HoDZadkiel/EnviroSense/docs/overview.md

# 設計總覽

> 本文件是專案 README 原本的長篇設計說明，為了讓 README 回到「簡介與快速開始」而移到這裡，內容未改（僅調整連結）。
> 專案簡介、快速開始與硬體規格見 [README](../README.md)。
> 2026-10-28 已依現行設計更新：電池以 **21700（5000 mAh）** 為準、設定頁改連按兩次 RESET、里程碑與未完成項目對照現場運行狀況。
> 韌體原始碼不公開，文中提到原始碼的地方只是設計說明。

## 核心結論：成敗在 WiFi 連線優化

決定「醒來就傳」之後，**上傳佔了電路總耗電的 76.2%**（5 分鐘模式），
深睡電流只佔 4.3%。喚醒視窗的長度幾乎就是唯一的設計變數。

未優化的 Arduino 寫法（`WiFi.begin(ssid, pass)` + DHCP + DNS）約需 **4 秒**，
把時間花在這些地方：

| 階段 | 未優化 | 優化後 | 手段 |
|---|---|---|---|
| 開機 / 載入 app | 250 ms | 150 ms | 跳過映像驗證、QIO 80MHz |
| WiFi init + start | 300 ms | 210 ms | PHY 部分校正 |
| **全頻掃描找 AP** | 800 ms | **0 ms** | 快取 BSSID + channel |
| **關聯 + WPA2 握手**  | 1100 ms | 350 ms | 已知 BSSID/channel、訊號好 |
| **DHCP 取得 IP** | 1000 ms | **0 ms** | 靜態 IP |
| DNS 查 broker | 200 ms | **0 ms** | 直接寫 IP |
| MQTT 連線+送出+斷線 | 300 ms | 250 ms | 不開 TLS、payload 小 |
| 收尾進睡 | 50 ms | 40 ms | |
| **合計** | **4000 ms** | **1000 ms** | **能量降為 22%** |

**這個優化把 5 分鐘模式從不可行變成可行**：

| 間隔 | 未優化 (4.0 s) | 優化後 (1.0 s) | 6 個月所需視窗  |
|---|---|---|---|
| 5 分鐘  | 4.4 個月 ❌ | **14.7 個月** ✅ | ≤ 3.14 s  |
| 15 分鐘 | 11.0 個月 ✅ | **26.8 個月** ✅ | ≤ 9.41 s  |
| 30 分鐘 | 17.7 個月 ✅ | **33.8 個月** ✅ | ≤ 18.82 s |

（21700 5000mAh，含電池自放電與載板 DW01A 保護 IC 靜態電流；數字來自功耗模型，見 [功耗預算](./power-budget.md)。
早期設計用 18650 3000mAh，5 分鐘優化後只有 9.9 個月。）

手段逐項說明、實測數據與來源見 [`docs/wifi-optimization.md`](./wifi-optimization.md)。

## 選 5 / 15 / 30 分鐘哪一個（另有 1 分鐘，僅供續航測試）

| | 5 分鐘 | 15 分鐘 | 30 分鐘 |
|---|---|---|---|
| 續航（21700，優化後） | 14.7 個月 | 26.8 個月 | 33.8 個月 |
| 續航（18650，早期設計） | 9.9 個月 | 20.1 個月 | 27.1 個月 |
| WiFi 優化 | **必要條件** | 加分項 | 加分項 |
| 視窗餘裕（以 1.0 s 計）  | 1.0 / 3.14 s，3.1 倍 | 9.4 s，9.4 倍 | 18.8 s，19 倍  |
| 對 AP 慢的容忍度 | 低 | 高 | 很高 |

**實測結果：視窗遠比預期短。** 已上線節點的 `up` 中位數 523 ms，加上 MQTT 收尾約 0.8 秒，
遠低於 5 分鐘模式的 3.14 秒上限，所以 5 分鐘已證實可行（估算約 16.7 個月，見 [功耗預算](./power-budget.md)）。
韌體把間隔做成可調（設定頁或 MQTT 指令），1 分鐘僅供續航測試。

超過 24 個月的數字沒有實務意義 —— 那時電池自放電與日曆老化的不確定性遠大於負載本身，
所以 30 分鐘的「33.8 個月」實際上應理解為「規劃一年充一次電，餘裕很大」。

## 為什麼是 C6

C3 的板載 LDO（XC6210）靜態電流就有 35 µA，佔其深睡總電流的 78%；
S3/C6 改用 **SGM6029 同步 buck**（2.8 µA，不是 LDO）。從 BAT 焊盤實測的深睡電流差了 3 倍：

| | C3 | S3 | C6（選用） |
|---|---|---|---|
| 深睡實測（BAT 焊盤 3.8V） | 45.1 µA | 11.9 µA | 14.3 µA |
| PSRAM | 無 | 8 MB（喚醒時的負擔） | 無 |
| 充電電流 | 380 mA  | 50 mA | 120 mA |
| 5 分鐘續航（優化後） | 9.1 個月  | 9.2 個月 | **9.9 個月**  |
| 30 分鐘續航（優化後） | 21.6 個月 | 26.6 個月 | **27.1 個月** |

兩個要點：

- **間隔越短，選型越不重要**。5 分鐘時 C6 只領先 C3 9%，因為深睡只佔 4.3%。 這也再次說明：**5 分鐘模式的勝負在 WiFi 優化，不在換板子**
- **S3 深睡最低卻不推薦**：8MB PSRAM 初始化 + 雙核 Xtensa 讓每次喚醒更慢更耗電， 在 5 分鐘時只贏 C3 0.2 個月。且充電只有 50 mA

充電電流看似 C3 大勝，但 9~28 個月才充一次電，C6 用 120 mA 充 21700（5000 mAh）約 42 小時（定電流段，實際略長），完全可接受。
（C6 的充電 IC 是 **SGM40567-4.2**，官方文件寫 100 mA，但原理圖上 R_IREF = 200kΩ
反推是 120 mA。詳見 [`docs/mcu-selection.md`](./mcu-selection.md)。）
完整比較與來源見 [`docs/mcu-selection.md`](./mcu-selection.md)。

## 專案結構

```
EnviroSense/
├── README.md / CLAUDE.md / CHANGELOG.md
├── docs/                設計文件（本檔、power-budget、hardware、mqtt-protocol…）
│   └── data/            遙測資料快照（CSV）
├── hardware/            EasyEDA 專案、Gerber、BOM
├── firmware/release/    預編譯韌體、esptool、flash 腳本（原始碼不公開）
├── web-flasher/         網頁燒錄頁模板
├── deploy/              Mosquitto 與 Home Assistant 設定範例
├── scripts/             power_budget.py 功耗試算（所有月數的唯一來源）
└── .github/workflows/   Pages 部署、原始碼外洩防護
```

## 硬體摘要

| 項目 | 選型 | 重點 |
|---|---|---|
| MCU  | Seeed XIAO ESP32C6 | 深睡 14.3 µA、板載充電 **120 mA**（SGM40567-4.2）、u.FL 外接天線 |
| 感測器  | Nyfea SHT40-N-NF | 待機 0.1 µA、量測 6.9 ms、±1.8%RH ±0.2°C、指令相容 SHT4x |
| 電池 | **21700**（載板電池座 BH-21700-B1BJ001） | 截止電壓 **3.3V**，不是 3.0V |
| 電壓量測 | 2MΩ/2MΩ 分壓 **+ 2N7002 閘控** | 官方建議的 200k 分壓會漏 10.5 µA |

**截止電壓 3.3V 的原因**：WiFi 發射瞬間電流達 250~350 mA，電池內阻加 LDO 壓降會讓電壓塌陷。
靜態電壓低於 ~3.4V 時發射瞬間就可能 brownout 重啟 ——
症狀是節點在低電量時隨機重開機、資料出現缺口。放棄最後 3~5% 電量換穩定性划算。

**分壓一定要閘控**：官方建議的 200k 分壓常時漏 10.5 µA，
會讓深睡電流從 14.3 µA 變 24.8 µA。用 2M/2M + 2N7002 閘控可降到接近 0。

電路、接線、BOM 見 [`docs/hardware.md`](./hardware.md)。

## 設定與佈建（WiFiManager）

使用者透過手機連上節點開的 AP 設定，不需重編譯。可設定的項目：
WiFi 憑證、**上傳間隔（1 / 5 / 15 / 30 分鐘下拉選單，1 分鐘僅供測試）**、MQTT broker、以及 IP 策略。

低功耗專案用 WiFiManager 有兩個會咬人的地方，都已在設計中處理：

### 設定入口網站絕不能自動開啟

WiFiManager 預設「連不上就開 portal 等人來設定」。portal 開著約 80 mA，
開 3 分鐘 = **4.0 mAh = 15 分鐘模式一整天的電**。
若因為路由器重開機而每次喚醒都誤開，**電池 6 天見底**。

所以：**連線失敗絕不開 portal**，只把資料存進 pending、指數退避、回去睡。
設定模式只能由人明確觸發（冷開機後 10 秒內連按兩次 RESET；原版曾用 BOOT 鍵，見 [設定與佈建](./provisioning.md)），且有硬性逾時與低電量拒絕。

10 秒的按鍵等待用開機原因迴避 ——
深睡計時器喚醒就是例行上傳，完全跳過等待，零延遲。

### 「記住 DHCP 給的 IP」的假設要修正

靜態 IP 這單獨一項值 **+37% ~ +80%** 續航，**5 分鐘模式靠它才達標**（5.5 → 9.9 個月），
所以很值得做。但「DHCP 會自動避免發同一個 IP 給不同設備」這個前提不成立：

- 節點改用靜態後就不再續約 → 租約必定過期 → IP 回到可分配池
- 家用路由器有黏性，**短期內通常真的沒事**，所以問題會在數週後才浮現
- **關鍵**：路由器發 IP 前的衝突偵測（ping / ARP 探測）對本專案無效 —— 節點 99.9% 在深睡不會回應，路由器判定沒人用就發給別人。 **一般保護靜態 IP 的安全網，剛好對深睡裝置失效**

對策是保留這個做法，但加上續約與退路：

| 模式 | 做法 |
|---|---|
| **自動**（預設，新手不必碰路由器） | 首次 DHCP → 記住 IP → 之後靜態；**每天一次改走 DHCP 續約**；失敗自動退回 DHCP 重新記錄 |
| 手動 | 使用者填路由器保留的 IP，**最安全** |
| 關閉 | 每次都 DHCP，每次多約 1 秒 |

每日續約的成本 **< 1% 續航**，換掉一個數週後才爆發的隱性故障。
設定頁用「☑ 記住 IP 位址以加快連線（推薦）」呈現，避免出現 DHCP、子網路遮罩這種字眼。

完整設計見 [`docs/provisioning.md`](./provisioning.md)。

## 韌體架構

每次喚醒都是一次完整的 `setup()`，沒有 `loop()`。狀態存在 **RTC memory**
（深睡保留、免寫 flash、無磨損）：

```
喚醒
 ├─ 開機原因 != 深睡喚醒？ → 檢查電壓 → LED 亮 10 秒，期間再按一次 RESET → 設定模式
 │                          （例行喚醒完全跳過，零延遲；NVS 沒設定才自動進設定模式）
 ├─ 讀 RTC memory（seq / WiFi cache / 待補送資料 / 失敗次數）+ CRC 校驗
 ├─ 讀 NVS（間隔 / broker / IP 策略 / 快取的 IP）
 ├─ 今天該續約嗎？（每 1440/間隔 次）→ 是則走 DHCP，否則：
 ├─ WiFi.config(快取的 IP)                     ← 跳過 DHCP，省 ~1000ms
 ├─ WiFi.begin(ssid, pass, ch, bssid)          ← 跳過掃描，省 ~800ms
 ├─ ── 趁 WiFi 在背景關聯，同時做以下事 ──      ← 並行，省 ~20ms
 │    ├─ 讀 SHT40（高精度 8.2ms）
 │    └─ 拉高 2N7002 閘極（分壓 τ = 100 ms，要等 ≥ 500 ms 才能讀，見 docs/hardware.md）
 ├─ 等待 WiFi 連上（逾時 5s → 清 cache，全頻掃描挑訊號最強的 AP 重試一次，逾時 30s）
 ├─ 讀電池電壓（dummy read → 讀 → 拉低閘極）   ← 此時閘極已開 ≥ 500 ms
 ├─ esp_wifi_set_ps(WIFI_PS_NONE)              ← 視窗只有 1 秒，求快不求省
 ├─ MQTT connect(clean session, IP 直連) → publish QoS1 → disconnect
 │   ├─ 成功：更新 WiFi cache、清待補送、failCount = 0
 │   └─ 失敗：存進 pending、failCount++、指數退避、
 │             下次改走 DHCP 重新記錄 IP（flags: ip_recache）
 │             ⚠ 絕不開設定入口網站
 └─ esp_deep_sleep(下次間隔)
```

**RTC memory 而非 NVS**：WiFi cache 每次都可能更新，寫 NVS 既耗電又磨損 flash。
NVS 只放 WiFi 憑證這類幾乎不變的設定。RTC memory 內容在異常重開後可能是垃圾，**必須做 CRC 校驗**。

**時間戳不需要處理**：醒來即傳，所以 broker 收到的時間就是量測時間（誤差 < 1 秒）。
不需要 NTP，RTC 振盪器 ±3~5% 的漂移只影響取樣間隔，不影響資料時間正確性。

## MQTT 摘要

```
envirosense/<node_id>/state    ← 感測資料（JSON，QoS1，不 retain）
envirosense/<node_id>/status   ← LWT：online / offline（retain）
envirosense/<node_id>/cmd      ← 下行指令（約一天才訂閱一次）
homeassistant/sensor/...       ← HA 自動探索（retain，僅首次開機發送）
```

```json
{"id":"a1b2c3","seq":1234,"t":24.31,"h":58.2,"vbat":3.92,"rssi":-58,"up":980,"flags":[]}
```

`up` = 本次喚醒視窗耗時（ms），`rssi` = 訊號強度。
**把這兩個欄位存進資料庫，就能在電池真的沒電之前先看出 WiFi 變慢。**
成本 8 bytes，價值是提早幾個月預警。

因為不做批次緩衝，**Home Assistant 完全相容**，不需要額外的資料庫橋接。
完整規格見 [`docs/mqtt-protocol.md`](./mqtt-protocol.md)。

## 開發里程碑

**本專案直接做 PCB，不經洞洞板驗證** —— M5 先行，其餘驗證都在打樣回來的實體板上進行。
里程碑編號沿用原定義，狀態對照 2026-10-28 的現場運行資料（4 個節點、1 分鐘與 5 分鐘間隔）：

- [x] **M5 硬體載板** — EasyEDA Pro 畫板、打樣、焊接完成，見 [`hardware/`](../hardware/)
- [ ] **M0 可行性實測** — 在實體板上實測 C6 深睡電流（驗收：接近 14.3 µA）。
      **延後**：沒有 PPK2，時程未定；改以 M6 實際運行數據估算
      （代價：焊接瑕疵造成的深睡漏電要到 M6 才看得出來，且看不出原因）
- [x] **M1 最小韌體** — 深睡 → 讀 SHT40 → 開 WiFi → MQTT 上傳 → 睡，已在實板運作
- [ ] **M2 WiFi 優化** — 靜態 IP、BSSID 快取、每日 DHCP 續約已實作並在現場運作（`up` 中位 523 ms），
      但**逐項 A/B 對照實測還沒做**，也還沒用 PPK2 回填各階段電流到 `scripts/power_budget.py`
- [x] **M3 韌體強健化** — RTC memory + CRC、失敗補送（`pending`）、指數退避；現場已看到補送與 `seq` 追漏
- [x] **M4 電池管理** — 閘控分壓量測、四段式低電量處理；現場已看到 `low_batt` 旗標與間隔拉長
- [ ] **M6 長期驗證** — 一顆節點連續跑 30 天，用實際放電曲線外推續航（進行中，已累積約 11 天）

WiFiManager 設定頁（連按兩次 RESET 觸發）、HA 自動探索、`cmd` 下行指令也已在實機運作。

## 未完成項目 / 待決事項

- **平均電流仍是估計值**（最高風險）：喚醒視窗長度已在現場量到（`up` 中位 523 ms，加 MQTT 收尾約 0.8 s，比原本假設的 1.0 s 短），但視窗內的**平均電流（75.8 mA）仍是模型值**，還沒用 PPK2 量過。見 [功耗預算](./power-budget.md)
- **BSSID + channel 快取的效果有互相矛盾的證據**：社群宣稱可省 800 ms， 但 Espressif 官方 FAQ 說 ESP32 無法靠 BSSID 加速，且有實測回報用了仍花 3201 ms。 **A/B 對照還沒做**，無效就別留著。新韌體的兩個節點約 6 天內 `cache_miss` 只出現 1 次，但沒有關閉快取的對照組，無法下結論
- **Arduino framework 改不了 sdkconfig**：跳過映像驗證、PHY 校正、RTC 校正三項 是 ESP-IDF 選項，Arduino core 是預編譯二進位檔。這三項合計只省約 250 ms， 建議先走純 Arduino（可拿到 4000 → 1250 ms），不夠再考慮換 ESP-IDF
- **深睡電流未自行實測**：14.3 µA 來自第三方論壇量測
- **間隔未定案**：實測視窗已證實 5 分鐘可行，最終間隔依使用情境決定（續航與資料密度的取捨）
- **C6 的 RF switch 未確認**：C6 疑似有板載天線 + u.FL 兩路由 GPIO 切換， 該腳在深睡時的狀態可能影響耗電
- **C6 的 WiFi6 相容性只有單一環境的觀察**：在現場 mesh AP 上 `up` 中位 523 ms，沒看到變慢；沒有針對 WiFi 4 / 5 / 6 做對照，AP 型號也未記錄
- **佈署環境未定**：室內或戶外？戶外必須用百葉箱，否則日照直射會讓溫度偏高 5~10°C
- **WiFiManager 的體積代價未量測**：會拉進 WebServer + DNSServer，binary 變大。 若沒開 skip-validate，bootloader 每次醒來對整個映像算 SHA256 的時間與大小成正比 —— **M2 必須量加入前後的喚醒視窗差多少**
- **授權條款未定**：尚未建立 LICENSE

### 若 1.0 秒還不夠：ESP-NOW

唯一能再降一個數量級的方法是**不建立 WiFi 連線**。ESP-NOW 不掃描、不關聯、不握手、不要 IP，
喚醒視窗可壓到 **450 ms**，5 分鐘模式續航 **20.4 個月**（是優化後 WiFi 的 2 倍）。

代價是需要一台常供電的 gateway 把 ESP-NOW 轉發成 MQTT，多一個裝置與故障點。
**建議先做完 M2 拿到真實數據再決定** —— 若選 15 或 30 分鐘，WiFi 版已有 20~27 個月，
不需要 gateway 的複雜度。詳見 [`docs/wifi-optimization.md`](./wifi-optimization.md)。

## 注意事項

- **不要引用晶片 datasheet 的深睡電流**。C3 與 C6 同代製程，深睡卻差 3 倍， 差別全在板子的 LDO 選型。要看「從 BAT 焊盤實測」的數字
- **量功耗一定要用 release build 且不插 USB**。插著 USB 時板載充電 IC 會同時供電與充電， 量到的數字毫無意義；USB CDC 開著也會拉長開機時間
- **WiFi 訊號品質直接換算成續航**。優化後 WPA2 握手佔視窗能量 46.2%， 而握手時間取決於 AP 回應速度與訊號品質，節點端無能為力。 佈署點 RSSI 應優於 **-70 dBm**，使用外接天線，**AP 不要開自動換頻道**（會讓快取失效）
- **不要為了省電降頻**。能量 = 功率 × 時間，160 MHz 跑完 1 秒比 80 MHz 跑完 1.8 秒省
- **靜態 IP 必須在路由器排除於 DHCP 池外**，否則遲早撞 IP，症狀是偶發性連不上
- **鋰電池低溫容量衰減**：0°C 約剩 80%，-10°C 約剩 60%。戶外冬季要把上表月數再打折
- 裸電芯務必外加保護板（DW01+8205A），但其過放點在 2.4~2.9V，遠低於本設計的 3.3V —— **保護板保護電芯不燒毀，續航與資料完整性靠韌體**
- 專案已公開在 GitHub：<https://github.com/HoDZadkiel/EnviroSense>，內容只有文件、硬體設計與預編譯韌體，**韌體原始碼不公開**

---

異動紀錄見 [`CHANGELOG.md`](../CHANGELOG.md)。
