HoDZadkiel/EnviroSense/docs/hardware.md

# 硬體設計

## 選型總表

| 項目 | 選型 | 理由 |
|---|---|---|
| MCU | **Seeed XIAO ESP32C6** | 深睡實測 14.3µA、無 PSRAM 負擔、板載充電 120mA（SGM40567-4.2）。詳見 [`mcu-selection.md`](./mcu-selection.md)；EasyEDA 匯入見下方「EDA 素材」 |
| 溫濕度感測器 | **Nyfea SHT40-N-NF**（LCSC `C54946589`） | 待機 0.1µA、±1.8%RH ±0.2°C、I²C 0x44、指令與 Sensirion SHT4x 相容。見下方「感測器選型」 |
| 電池 | **18650**；5 分鐘間隔可考慮 **21700** | 見 [`power-budget.md`](./power-budget.md) |
| 電池座 | Keystone 1043（18650）/ 對應 21700 座 | 需可換電芯，不焊死 |
| 電壓量測 | 2MΩ + 2MΩ 分壓，2N7002 閘控 | 見下方 |
| 天線 | u.FL 外接 2.4GHz | RSSI 改善直接換算成續航 |

## 為什麼分壓要閘控

XIAO 系列**沒有任何一款有專用的電池電壓量測腳**（C3/S3/C6 皆同），
官方文件都建議自己接分壓到 A0。但分壓電阻是常時導通的：

| 分壓阻值 | 常時漏電 | 佔 C6 深睡 14.3µA 的比例 |
|---|---|---|
| 100k + 100k | 21 µA | **147%**（比整個板子還耗電） |
| 200k + 200k（官方建議） | 10.5 µA | **73%** |
| 1M + 1M | 2.1 µA  | 15% |
| 2M + 2M | 1.05 µA | 7.3% |
| 2M + 2M **+ 2N7002 閘控** | ~0 µA | ~0% |

官方建議的 200k 分壓會讓深睡電流從 14.3µA 變成 24.8µA。
影響程度隨間隔而異：5 分鐘模式深睡只佔總耗電 4.3%，掉約 3%；
30 分鐘模式深睡佔 11.8%，掉約 8%。**間隔越長，這個漏電越值得處理。**
所以本專案用 **2M/2M + N-MOSFET 閘控**：分壓下端接 2N7002 汲極，
閘極由 GPIO 控制，只有要量的時候才拉高。

```
        BAT+ ──┬── XIAO BAT 焊盤
               │
              2MΩ
               │
               ├──────┬──── A0 (ADC)
               │      │
              2MΩ    100nF   ← 給 ADC 取樣電容充電用
               │      │
            2N7002 D  │
               G ─────┼──── D3 (GPIO, 量測時拉高)
               S      │
        BAT- ──┴──────┴──── GND
```

- **2MΩ 對 ADC 而言阻抗偏高**，ESP32 ADC 建議源阻抗 < 100kΩ，故加 100nF 並聯， 讀取前先做一次 dummy read 丟棄
- ⚠ **穩定時間是 500 ms，不是 10 ms**（原本寫 10 ms 是錯的）： 電容看出去的等效電阻是 2M∥2M = 1MΩ，**τ = 1MΩ × 100nF = 100 ms**。 而且方向是「放電」不是「充電」—— 閘極關閉時 A0 經 R1 被拉向 Vbat （被 ESD 二極體鉗在 ~3.6V），開啟後要降到 Vbat/2。10 ms 只走了 0.1τ，讀值會飽和。 **板子已打樣，用韌體繞過**：醒來立刻拉高閘極，等 WiFi 連上（≥ 500 ms = 5τ，誤差 < 1%） 再讀，與關聯並行、不拉長喚醒視窗。若日後改版，C1 改 10nF 即可把 τ 降到 10 ms
- 讀完立刻拉低閘極
- ⚠ **閘極沒有下拉電阻**：D3（GPIO21）深睡時浮接，2N7002 可能半導通讓分壓漏電 （上限 Vbat / 4MΩ ≈ 1 µA）。M0 要量深睡電流確認；若偏高，在 Q2 的 G–S 兩腳間 補焊一顆 1MΩ，下一版改版時放進原理圖
- 使用 `analogReadMilliVolts()` 而非 `analogRead()`，它會套用晶片內建的 ADC 校正
- 分壓比 1:2，所以 `Vbat = 讀值 × 2`，但**實際比例要用萬用表校正**（電阻誤差 1%）

## 接線

XIAO 腳位以絲印的 D 編號為準（實際 GPIO 編號依 Arduino variant 定義，M1 時確認）。

| XIAO 腳 | 接到 | 說明 |
|---|---|---|
| 3V3 | SHT40 VDD、10kΩ×2 上拉 | 待機 0.1µA，不需閘控  |
| GND | SHT40 GND、分壓下端 | |
| D4 (SDA) | SHT40 SDA | 10kΩ 上拉到 3V3 |
| D5 (SCL) | SHT40 SCL | 10kΩ 上拉到 3V3 |
| A0 | 分壓中點 | 並 100nF 到 GND  |
| D3 | 2N7002 閘極 | 高 = 啟用分壓 |
| BAT+ / BAT- 焊盤 | 電池座 | **注意極性，接反會燒板** |

- SHT40 加 **100nF 去耦電容**貼近 VDD
- I²C 上拉用 10kΩ（不用 4.7kΩ）：I²C 匯流排閒置時為高電位，不耗靜態電流， 但量測期間拉低時 4.7kΩ 會多耗一倍電流，且本專案匯流排極短、速率低，10kΩ 綽綽有餘

### ⚠ I²C 上拉是這顆電路最大的靜默漏電風險

匯流排閒置為高電位時不耗電，但**只要 SDA 或 SCL 在深睡期間被拉低**：

```
3.3 V / 10 kΩ × 2 = 660 µA（單一條被拉低則 330 µA）
```

330 µA 是深睡預算 14.3 µA 的 **23 倍**，電池幾天就見底，而且沒有任何外顯症狀。
會發生的情境有兩種：

1. 對 I²C 腳呼叫了 `gpio_hold_en()`，或不小心開了內部下拉，深睡時被鎖在低電位 （ESP32-C6 深睡時 GPIO 預設高阻抗，正常不會發生）
2. MCU 在 I²C 讀取途中重開機（brownout 很容易造成），**感測器會把 SDA 拉住不放**

對策：深睡前確認 I²C 腳未被 hold、未開內部下拉；醒來後先做
**I²C bus recovery**（送 9 個 clock 脈衝）再開始通訊。
**M0 實測務必包含這一項** —— 接上感測器後深睡電流應仍為 ~14.7 µA，
若量到 300 µA 以上，原因幾乎一定是這條。

## 感測器選型

定案為 **Nyfea SHT40-N-NF（LCSC** `C54946589`**）**，Sensirion SHT40 的相容品。

規格書：[`Nyfea SHT40-N-NF.pdf`](../hardware/datasheets/Nyfea%20SHT40-N-NF.pdf)（Nyfea product specification，15 頁）

| 候選 | 廠牌 | 單價 | RH 精度 | RH 年漂移 | 待機電流 |
|---|---|---|---|---|---|
| **SHT40-N-NF（選用）** | Nyfea 副廠 | $0.95 (LCSC) | ±1.8% | <0.3 %RH/y | **0.1 µA** typ |
| SHT40-AD1B-R2 | Sensirion 原廠 | $1.88 (DigiKey) / LCSC `C2909890` | ±1.8% | <0.2 %RH/y | 0.08 µA typ |
| HDC3022DEJR | TI 原廠 | $1.60 (LCSC `C17434731`) | ±0.5% | 0.19 %RH/y、IP67 蓋 | 0.4 µA¹ |
| SHT45-AD1B | Sensirion 原廠 | **$7.00** (DigiKey) | ±1.0% | <0.2 %RH/y | 0.08 µA typ |

¹ TI 標的 400 nA 是 **average current**，其 idle 電流未查證，可能同樣遠低於此值。

選 SHT40 的理由是**居家溫濕度不需要 ±0.5% 等級的精度**，±1.8%RH / ±0.2°C 綽綽有餘。

**待機電流也確實是選它的加分項**：0.1 µA（typ，min 0.08 / max 0.15）與 Sensirion 原廠的
0.08 µA 實質同級。不過要留意，即使差到 0.4 µA，實算也只影響續航 0.1%（5 分鐘）~
0.3%（30 分鐘） —— 在這個電路裡任何 1 µA 以下的東西都不足以主導選型
（對比：分壓電阻的 10.5 µA 才值得花一顆 MOSFET 去閘控）。

**注意規格書上「Average current 0.4 µA」不是待機電流**，
那是在「1 Hz、低重複度連續取樣」條件下的平均值。兩者差 4 倍，很容易看錯。

**感測器不需要閘控，也不需要進睡眠**：SHT4x 沒有 sleep 指令，
單次量測結束後會自己回到 idle。

### 規格書核對結果：與 Sensirion SHT4x 完全相容

原本擔心副廠只有 pin-to-pin 相容、韌體要重寫。**核對規格書後確認不必**：

| 項目 | Nyfea SHT40-N-NF | 與 Sensirion SHT4x |
|---|---|---|
| I²C 位址 | `0x44` | 相同 |
| 量測指令 | `0xFD` 高 / `0xF6` 中 / `0xE0` 低重複度 | 相同 |
| 其他指令 | `0x89` 讀序號、`0x94` soft reset、加熱器 `0x39`/`0x32`/`0x2F`/`0x24`/`0x1E`/`0x15` | 相同 |
| CRC | CRC-8、多項式 `0x31`、init `0xFF`、不反射、final XOR `0x00`、`CRC(0xBEEF)=0x92` | 相同 |
| 量測時間（高重複度） | 6.9 ms typ / 8.3 ms max | 相同量級（8.2 ms max）  |

**現有 SHT4x Arduino library 應可直接驅動**，`firmware/` 不需改動。

其餘規格：量測電流 300 µA typ / 500 µA max、上電時間 0.3 ms typ、soft reset 1 ms、
遲滯 ±0.8 %RH、響應時間 t63% 為 RH 4 s / T 2 s、供電 1.6~5.5 V。
規格書聲稱 NIST traceability 與 JEDEC JESD47 qualification。
（規格書註明 max 值是在 1.6 V 供電下量的，本專案跑 3.3 V，實際會更好。）

規格表內文多處寫成「FHT40」—— 這顆就是 Nyfea 自有的 FHT40 掛 SHT40-N-NF 型號出貨。

### 仍要接受的風險

規格書把數字都標齊了，但**副廠沒有 Sensirion 的長期實績**，年漂移 <0.3 %RH/y
也比原廠的 <0.2 %RH/y 寬 1.5 倍。跑一兩年的長期趨勢仍以 M6 實測為準。
與原廠只差約 $0.9，若日後發現漂移過大，直接換 `C2909890` 即可（pin 與指令皆相容）。

M1 仍建議實測確認（規格書是廠商自述，不等於實物）：

- [ ] 讀序號 `0x89` 有回應、CRC 校驗通過
- [ ] `0xFD` 實際轉換時間落在 6.9~8.3 ms
- [ ] 實測待機電流接近 0.1 µA

## BOM（初版）

> ⚠ **本表是排版前的規劃版，已打樣的板子以** `hardware/bom/BOM_Board1_PCB1_2026-08-21.xlsx`
> **為準**。兩者不一致之處（2026-09-30 對照實際網表確認）：
>
> | 本表                                      | 實際打樣板                                                                       |
> |-----------------------------------------|-----------------------------------------------------------------------------|
> | XIAO 用兩支 1×7P 母排針插拔                     | U3 用 `LCC-14P` castellated 封裝**直接焊接**，BOM 無母排針                              |
> | 18650 座（Keystone 1043）                  | U4 = **BH-21700-B1BJ001**（21700 座）                                          |
> | 8205A：`C504156` / TSSOP-8 `C18191787`   | Q3 = JSMSEMI **SOT-23-6** `C2762931`                                        |
> | 100Ω / 1kΩ 為 0603（`C105588` / `C22548`） | R5 / R6 為 **0805**（`C17408` / `C17513`）                                     |
> | 2.4GHz u.FL 陶瓷天線（載板料件）                  | 不在載板上。XIAO C6 自帶陶瓷天線 + u.FL，外接的是帶線天線；韌體需切 RF switch（GPIO3 / GPIO14）才會走 u.FL |
>
> Q3 的腳位對應需在焊接前確認：網表是 pin1 接電芯負極、pin3 接 B-、pin6/4 接 OD/OC，
> 成立的前提是 SOT-23-6 版 1 = S1、3 = S2，但 `JSMSEMI 8205A.pdf` 這個封裝的底排腳名標示殘缺，
> 請對照 LCSC `C2762931` 商品頁的腳位圖。

每一列的 LCSC 料號都逐一開頁面核對過（不是只憑搜尋結果引用），核對方式與結果見下方備註欄。

| 項目 | 型號 | 數量 | LCSC 連結 | 備註 |
|---|---|---|---|---|
| MCU 模組 | Seeed XIAO ESP32C6 | 1 | [JLCPCB `C9900124963`](https://jlcpcb.com/partdetail/seeedStudio-XIAOESP32C6/C9900124963) | **只在 JLCPCB 零件庫，不是 LCSC 一般商城可獨立購買**（頁面註明「purchased components are stored in your JLCPCB parts library for future PCBA orders only」）。要單買模組請走 Seeed 官網，這個料號只在**用 JLCPCB 代工組裝**時才能點用 |
| 溫濕度感測器 | Nyfea SHT40-N-NF (DFN-4 1.5×1.5) | 1 | [`C54946589`](https://www.lcsc.com/product-detail/C54946589.html) | 已核對，現貨 1,896 顆 |
| （原廠替代） | Sensirion SHT40-AD1B-R2 | – | [`C2909890`](https://www.lcsc.com/product-detail/C2909890.html) | 商品頁核對時逾時，改核對其[規格書連結](https://www.lcsc.com/datasheet/C2909890.pdf)確認料號存在，現貨量未查 |
| 電池保護 IC | DW01A (SOT-23-6) | 1 | [`C351410`](https://www.lcsc.com/product-detail/C351410.html) | 已核對，現貨 130,900 顆 |
| 保護 MOSFET | 8205A 雙 N 通道 (SOT-23-6) | 1 | [`C504156`](https://www.lcsc.com/product-detail/C504156.html) | CJL8205A，**已核對但目前缺貨**，下單前查現貨或改找同規格替代（使用者匯出的 BOM 已改用 JSMSEMI TSSOP-8 版本 `C18191787`，經核對電氣拓樸相同，可行，見下方電池保護一節） |
| 分壓閘控 MOSFET | 2N7002 (SOT-23) | 1 | [`C8545`](https://www.lcsc.com/product-detail/C8545.html) | 已核對，現貨 150 萬+顆 |
| 電阻 | 2MΩ 1% 0603 | 2 | [`C114615`](https://www.lcsc.com/product-detail/C114615.html) | YAGEO RC0603FR-072ML，**已核對但目前缺貨**（可留「到貨通知」）。非常備料，M5 排程抓長一點 |
| 電阻 | 10kΩ 1% 0603 | 2 | [`C25804`](https://www.lcsc.com/product-detail/C25804.html) | UNI-ROYAL，JLCPCB 常備料，已核對。**I²C SDA/SCL 各一顆** |
| 電阻 | **100Ω 1% 0603**（新增） | 1 | [`C105588`](https://www.lcsc.com/product-detail/C105588.html) | YAGEO，已核對現貨 57,400 顆。**DW01A VCC 串接**，見下方電池保護一節 |
| 電阻 | **1kΩ 1% 0603**（新增） | 1 | [`C22548`](https://www.lcsc.com/product-detail/C22548.html) | YAGEO，已核對現貨 742 萬顆。**DW01A VM 串接**，見下方電池保護一節 |
| 電容 | 100nF 50V X7R 0603 | **3**（原列 2，**新增第 3 顆**） | [`C14663`](https://www.lcsc.com/product-detail/C14663.html) | YAGEO，JLCPCB 常備料，現貨千萬顆，已核對。**ADC 濾波 + SHT40 去耦 + DW01A VCC 去耦，三個不同位置**，不能共用一顆 |
| 電容 | 470µF 6.3V 低 ESR 鉭質聚合物 | 1 | [`C402828`](https://www.lcsc.com/product-detail/C402828.html) | Panasonic 6TPE470MI，ESR 18mΩ，已核對現貨 4,749 顆。**跨 BAT**，見下方「截止電壓」 |
| 天線 | 2.4GHz u.FL 陶瓷天線 | 1 | *查證失敗*，改用[天線分類頁](https://lcsc.com/products/Antennas_912.html) | 搜尋撈到的候選料號 (`C1693678`) 逐一開頁核對後回傳 404，**沒有可信料號**，下單前現搜 |
| 連接器 | **1×7P 2.54mm 母排針 ×2**（見右） | 2 | *查證失敗*，改用[母座分類頁](https://www.lcsc.com/category/793.html) | **不是單一顆 2×7P**：現貨核對到的 2×7P 品項（`C84005`）是雙排固定 2.54mm 列距的 SMD 座，跟 XIAO 實際兩排腳位的間距對不上（XIAO 兩排腳位間距遠大於 2.54mm）。要用**兩支獨立的 1×7P 母排針**分開擺，中心距依 Seeed 官方 PCB 檔實測，不能用一顆雙排零件卡死列距。候選料號 `C89130` 核對後回傳 404，未找到可信替代 |
| 電池座 | 18650 座（Keystone 1043 或同級） | 1 | 非 LCSC 品項 | LCSC 未上架，改走 [DigiKey](https://www.digikey.com/en/products/detail/keystone-electronics/1043/2745669) |
| 電池 | 18650 良品電芯 3000mAh | 1 | 非 LCSC / 一般零件通路品項 | 建議 Panasonic / Samsung / LG，向電池專門商採購 |

**核對方法與這次發現的問題**：先用網頁搜尋找候選料號，再**逐顆重新開 LCSC 商品頁確認**
（不是只信搜尋結果的摘要）。天線與母排針各有一個搜尋撈到的候選料號在逐一開頁時回傳
**404**，代表那組結果不可靠（可能是舊快取、或搜尋引擎誤讀），**已捨棄，不列入表格**，
改給分類頁讓你自己現查現貨。8205A 與 2MΩ 電阻雖核對出正確料號，**但目前缺貨**，
需在下單時另尋現貨或留通知。

## EDA 素材：XIAO ESP32C6 能不能匯入 EasyEDA

**能，且是官方級素材。** XIAO ESP32C6 整個模組已經被收進 LCSC / JLCPCB 零件庫，
**LCSC 料號** `C9900124963`，標記為可 SMT 代工組裝，且該頁面明確寫「schematic symbol
and PCB footprint are available in the EasyEDA PCB design tool」。

在 EasyEDA（Std 或 Pro）裡直接用「放置元件」搜尋 `C9900124963` 或 `XIAO-ESP32-C6`，
即可拉出**原理圖符號 + PCB 封裝**，不需要自己畫、也不用像 KiCad 那樣另外跑
`easyeda2kicad` 之類的轉換工具。

**但要注意這個模組化封裝跟本專案的用法對不上**：本 BOM 是用**兩支 1×7P 2.54mm 母排針**
把 XIAO 插上去（方便更換/燒錄，見上方 BOM），不是把 XIAO 直接焊死在板上。
LCSC 那個 `C9900124963` 封裝是給**直接焊接（castellated 邊緣鍍銅）的用法設計的。
另外這個料號只存在於 JLCPCB 零件庫**，不是 LCSC 商城可獨立下單購買的一般品項
（用途是 JLCPCB 代工組裝時勾選，不是拿來單買模組本體），細節見上方 BOM 備註。

**BAT+/BAT- 不在這 14 支腳裡**：那是模組底面另外兩顆獨立焊盤（見上方「接線」表），
充電 IC（SGM40567）與 USB-C 埠都在模組本體上，跟母排針插拔與否無關 ——
換成插拔式**不會**讓你失去充電功能，只是把 D0~D10/3V3/GND/5V 這 14 支訊號腳
從焊死改成用插座接觸而已。

所以實際排版時：

1. **原理圖**：可以放 `C9900124963` 的符號，拿它 14 支訊號腳的命名 （D0~D10、5V、3V3、GND）來接網路，省得自己重畫一次 pinout； BAT+/BAT- 另外飛線接電池座，不經過這顆符號
2. **PCB 封裝**：**不要**直接套用 `C9900124963` 的封裝（那是給焊死用的）。 改成**兩支獨立的 1×7P 2.54mm 母排針**，**不要用一顆固定 2.54mm 列距的 2×7P 雙排零件** ——查過 LCSC 現貨的 2×7P 品項列距是鎖死 2.54mm，跟 XIAO 實際兩排腳位的間距對不上。 兩支母排針的中心距要對到 Seeed 官方 KiCad 檔（ [`XIAO_ESP32_C6_v1.0_SCH&PCB_260114.zip`](https://files.seeedstudio.com/wiki/SeeedStudio-XIAO-ESP32C6/XIAO_ESP32_C6_v1.0_SCH&PCB_260114.zip)） 裡的實際孔距，不能只憑目測抓 2.54mm 網格

## 電池保護

若使用無保護板的裸電芯，**必須外加保護電路**：**DW01A（**`C351410`**）+ 8205A（**`C504156`**）**，
防止短路與過流。本專案直接做 PCB（未經洞洞板驗證），這組電路需在 M5 板卡上就位。

規格書：[`PUOLOP DW01A.pdf`](../hardware/datasheets/PUOLOP%20DW01A.pdf)。

### 8205A 就是 DW01A 用來切斷電流的開關

**是**。DW01A 本身不通過電池電流，它只做偵測與邏輯判斷，實際切斷/導通電流的
是 **8205A 這顆雙 N 通道 MOSFET**。以下是**直接把 datasheet 的 Typical Application
Circuit 頁面渲染成圖片、逐一追蹤走線後**畫出來的接線（先前這裡的版本是憑文字擷取
猜的，OC/OD 對應的 MOSFET 接反、VM 的接點也錯了，已重畫）：

```
        BATT+ ●─────────────────────────────────── pack 外部正極輸出
              │
             R1 100Ω
              │
             VCC(5) ┐
                     │  DW01A
             GND(6) ─┤
              │      │
    C1 0.1µF ─┘      │
              │       TD(4) ── 空接（NC）
    電芯負極 ──┴──────┐
                      │
                  OD(1) ── 閘極 ── M1（放電控制 FET，drain 接電芯負極）
                      │
                  M1／M2 共用節點（兩顆 drain 對接）
                      │
                  OC(3) ── 閘極 ── M2（充電控制 FET，source 接 pack 負極輸出）
                      │
        BATT- ●───────┴──────┬──────────────────── pack 外部負極輸出
                              │
                             R2 1kΩ
                              │
                             VM(2)
```

- **OD 腳**驅動 **M1**（放電控制，datasheet 原文：discharge control）， 過放或放電方向短路時拉低關閉
- **OC 腳**驅動 **M2**（充電控制，datasheet 原文：charge control）， 過充或充電方向過流時拉低關閉
- **VM 腳**經 **R2 (1kΩ)** 接到 pack 負極輸出（BATT-），不是接在 M1/M2 中點。 電流感測仍是靠兩顆 MOSFET 的導通電阻（Rds(on)）壓降，R2 的作用是 **保護 VM 這支腳**避免短路瞬間電壓超出腳位額定，**這顆電阻是必要料件，不能省略**
- **TD 腳空接**（Test pin for reduce delay time）。先前這裡寫「TD 接 OD」是誤讀 —— datasheet 圖上 TD 旁那條橫線是 IC 本體外框，不是走線。實際 PCB（由 `hardware/gerber/FlyingProbeTesting.json` 還原網表）U1 pin 4 也是空接，與 datasheet 一致
- **8205A 剛好是兩顆 N-MOSFET 封裝在一起、drain 對接**，正好對應 M1、M2 各一顆， 這是它與 DW01A 配對成為業界標準組合的原因

**這組電路除了 DW01A（**`C351410`**）與 8205A 本身，還需要三個先前 BOM 沒列的被動元件**：

| 元件 | 位置 | 作用 |
|---|---|---|
| **R1 = 100Ω** | BATT+ → DW01A VCC（串接） | 限制湧入 VCC 的電流 |
| **R2 = 1kΩ** | BATT- → DW01A VM（串接）  | 保護 VM 腳，短路時避免過壓 |
| **C1 = 100nF（0.1µF）** | DW01A VCC-GND 之間 | 去耦，**跟 ADC 濾波、SHT40 去耦是三顆不同位置的 100nF，不能共用** |

**保護點**（來源：datasheet Electrical Characteristics，均為 Ta=25°C）：

| 項目 | 數值 |
|---|---|
| 過充偵測 / 釋放 | 4.30V / 4.10V（±50mV） |
| **過放偵測 / 釋放** | **2.50V / 2.90V**（typ，無 min/max，僅標 typ） |
| 過流偵測 | 150mV ±20mV（跨 MOSFET 壓降），延遲 ~20ms |
| 短路偵測 | ~1.36V（跨 MOSFET 壓降），延遲 ~600µs |
| 靜態電流 | 3.0 typ / 6.0 max µA @Vcc=3.6V |
| Power-down 電流 | 4 µA typ @Vcc=1.8V（電池被判定過放關斷後的殘留電流） |

過放偵測 2.50V **遠低於本設計的 3.3V 截止**。
也就是說 —— **保護 IC 保護的是電芯不被燒毀，維持續航與資料完整性靠的是韌體**。
兩者不能互相取代：

| | 保護 IC | 韌體 |
|---|---|----|
| 短路 / 過流 | ✅（150mV / 1.36V 跨 MOSFET 偵測） | ❌  |
| 過充 | ✅（4.30V，另有板載充電 IC 6.5% ICHG 終止） | ❌  |
| 3.3V 就停止工作 | ❌（要到 2.50V 才動作） | ✅  |
| 低電量告警 | ❌ | ✅  |

## 截止電壓與突波塌陷

3.3V 截止的原因是 WiFi 發射瞬間的 250~350 mA 會讓電池內阻造成壓降，
靜態電壓低於 ~3.4V 時發射瞬間就可能 brownout 重啟。

**BOM 裡的 470~1000 µF 低 ESR 電容就是為了處理這件事**：發射是約 1 秒的脈衝，
電容把突波塌陷吸收掉，就能安全地把截止電壓從 3.3V 降到 ~3.1V。

⚠ **「零靜態電流」這個說法不成立**：C2（Panasonic 6TPE470MI 聚合物鉭）常時跨在電池上，
這類電容的漏電規格上限通常是 0.1·C·V ≈ 296 µA（系列慣例值，尚未對本料號 datasheet 核對），
實物一般遠低於此，但沒有規格保證低於深睡預算 14.3 µA。
**組裝時先不焊 C2**，M0 量完深睡電流後再焊上重量一次，差值就是 C2 漏電。
敏感度（`power_budget.py` 參數，21700 / 優化後 / 15 分鐘，已含 DW01A 3 µA）：

| C2 漏電 | 0 | 10 µA  | 50 µA  | 100 µA | 296 µA（規格上限） |
|---|---|---|---|---|---|
| 續航 | 26.8 月 | 25.6 月 | 21.5 月 | 18.0 月 | 10.9 月 |

即使踩到規格上限仍高於 6 個月目標，所以不致命，但要量出來才知道續航數字能不能信。

要注意 XIAO C6 的 3.3V 是由 **SGM6029 同步 buck**（不是 LDO）產生的：
Vbat 低於 3.3V 時它走 100% duty 變成直通，Vout ≈ Vbat − I×Rds(on)，
所以真正的下限是 ESP32-C6 自身的 **3.0V**，不是 LDO 壓降。

### 為什麼不做 buck-boost 榨到 2.5V

`usable_frac = 0.80` 裡的那 20% **不是全部躺在 3.3V 以下** ——
它是含老化與溫度的總體 derate，鋰電池 OCV 掉到 3.3V 時實際只剩 5~10%。
用 `scripts/power_budget.py` 實算（18650 / 優化後 / 15 分鐘）：

| 方案 | 續航 | 相對基準 |
|---|---|---|
| 基準（截止 3.3V） | 20.1 個月 | — |
| **加大電容，截止 ~3.1V** | 20.7 個月 | **+3.0%**  |
| 外掛 buck-boost 榨到 2.5V | 20.6 個月 | +2.3% |
| **換 21700 5000mAh** | 26.8 個月 | **+33.1%** |

buck-boost 多出來的容量被自身轉換損耗抵銷，淨增益只有 2%，
卻要付出電感、EMI、面積與額外 Iq。\*\*不做。\*\*想要更長續航就換 21700。

## 外殼與佈署

- **室內**：一般 ABS 盒即可，但需開通氣孔讓 SHT40 感受到真實濕度。 感測器不要密封在盒內，否則響應時間會從秒級變成十分鐘級
- **戶外**：必須用**百葉箱（Stevenson screen）**。直接曝曬的溫度讀數會比實際氣溫高 5~10°C， 這是氣象量測的基本要求，不是可選項
- **低溫**：0°C 時鋰電池可用容量約剩 80%，-10°C 約剩 60%。 戶外冬季佈署要把 [`power-budget.md`](./power-budget.md) 的月數再打折
- **結露**：高濕環境考慮在 SHT40 上方加 PTFE 透氣膜

## 待決事項

- [x] **~~XIAO ESP32C6 的天線切換~~** —— 官方原理圖確認：**有**。 U5 = **FM8625H** RF switch（VCTL 控制）+ ANT1 = KH5220-A36 陶瓷天線。 圖上註記「RF Switch 0: ON 1: OFF / RF Switch Port 0: RF1 1: RF2」。 控制腳疑似 GPIO14（致能）與 GPIO3（天線選擇），**腳位與深睡狀態仍需 M0 實測**
- [x] **~~C6 板載充電 IC 型號未知~~** —— 已確認 **SGM40567-4.2**，實際 **120mA** （R_IREF = 200kΩ，公式 `I_CHG = 24000/R`）。保護能力見 [`mcu-selection.md`](./mcu-selection.md)
- [x] ~~是否要做 PCB 載板（M5），還是先用洞洞板驗證~~ —— 已決定**直接做 PCB，不經洞洞板**
- [ ] 是否加設定按鍵（進入 WiFi 設定 AP 模式）—— 需一顆 GPIO + 上拉
- [ ] 是否需要外接第二顆感測器（土壤濕度 / 光照 / CO₂）—— 影響是否要留擴充座
