HoDZadkiel/EnviroSense/docs/mcu-selection.md

# XIAO ESP32 系列選型

> **注意（2026-10-28）**：本文續航數字以早期設計的 **18650（3000 mAh）** 計算。現行設計用 **21700（5000 mAh）**，
> 21700 的對應數字見 [power-budget.md](./power-budget.md)。

**結論：選 XIAO ESP32C6。**

## 為什麼不是直覺的 C3

原本假設 C3（最常見、生態最成熟）是預設選項，但查了實測數據後結論相反：
**C3 的深度睡眠電流比 S3/C6 高 3~4 倍**，原因在板載穩壓 IC。

| 板子 | 官方深睡 | 論壇實測¹ | 穩壓 IC | 型式 | 靜態電流 | 二極體反向漏電 |
|---|---|---|---|---|---|---|
| XIAO ESP32**C3** | 44 µA | **45.1 µA** | XC6210 | LDO | **35 µA** | NSR0520（低） |
| XIAO ESP32**S3** | 14 µA | **11.9 µA** | SGM6029 | **同步 buck** | 2.8 µA | LMBR4010（8 µA） |
| XIAO ESP32**C6** | 15 µA | **14.3 µA** | SGM6029 | **同步 buck** | 2.8 µA | LMBR4010（8 µA） |

¹ 實測條件：PPK2 從 **BAT 焊盤**供 3.8V（即本專案的實際供電方式），非從 3.3V 腳。
來源：[Seeed 論壇 - Comparison of Sleep Currents for XIAO ESP32C6, S3, and C3](https://forum.seeedstudio.com/t/comparison-of-sleep-currents-for-xiao-esp32c6-s3-and-c3/276444)

C3 用的 XC6210 是一般 LDO，**光靜態電流就 35µA**，佔了它 45µA 深睡總電流的 78%。
S3/C6 用的 **SGM6029 不是 LDO，是超低 Iq 的同步降壓 buck**（原理圖可見 SW 腳 + L1 0.47µH 電感），自動在 PFM / PWM 之間切換，靜態電流只有 2.8µA。
這個差別在低電量時有意義：buck 在 Vbat 低於 3.3V 時會走到 100% duty 變成直通，
Vout ≈ Vbat − I×Rds(on)，所以 brownout 門檻由 ESP32-C6 自身的 3.0V 下限決定，而不是 LDO 壓降。
S3/C6 剩下的電流大半來自 LMBR4010 蕭特基二極體 8µA 的反向漏電（C3 用的 NSR0520 反向漏電低）。

> 這個差異是**板子設計造成的，不是晶片造成的**。同樣是 ESP32 系列，
> 光是 LDO 選型就讓深睡電流差了 3 倍 —— 這也是為什麼不能直接引用晶片 datasheet 的數字。

## 三款完整比較

| 項目 | C3 | S3 | C6 |
|---|---|---|---|
| 核心 | RISC-V 單核 160MHz | Xtensa LX7 **雙核** 240MHz | RISC-V 單核 160MHz |
| Flash | 4 MB | 8 MB | 4 MB |
| PSRAM | 無 | **8 MB** | 無 |
| SRAM | 400 KB | 512 KB | 512 KB |
| 深睡實測 | 45.1 µA | **11.9 µA** | 14.3 µA |
| **充電電流** | **380 mA** 快充 / 40 mA 涓流 | **50 mA** 快充 / 3.8 mA 涓流 | **120 mA**（見下） |
| 無線 | WiFi 4 + BLE5 | WiFi 4 + BLE5 | **WiFi 6 + BLE5 + Zigbee/Thread** |
| 天線 | u.FL 外接（附天線） | u.FL 外接（附天線） | u.FL 外接 |
| 電池電壓量測 | 無專用腳，需外部分壓 | 無專用腳，需外部分壓 | 無專用腳，需外部分壓（接 A0） |

來源：[XIAO ESP32C3 Wiki](https://wiki.seeedstudio.com/XIAO_ESP32C3_Getting_Started/)、
[XIAO ESP32S3 Wiki](https://wiki.seeedstudio.com/xiao_esp32s3_getting_started/)、
[XIAO ESP32C6 Wiki](https://wiki.seeedstudio.com/xiao_esp32c6_getting_started/)

## 充電電流：看起來很嚴重，其實不是決策點

用板載充電模組充滿一顆電池要多久：

| | 18650 (3000mAh) | 21700 (5000mAh) |
|---|---|---|
| C3 @ 380mA | 約 9 小時 | 約 15 小時 |
| C6 @ 120mA | 約 28 小時 | 約 46 小時 |
| S3 @ 50mA | 約 66 小時 | 約 110 小時 |

S3 的 66 小時看起來荒謬，但**本專案 9~28 個月才充一次電**。
一年一次的維護動作花 33 小時（C6）插著 USB，完全可以接受 —— 晚上插著，隔天再隔天拔掉。

**所以充電電流不該主導選型。**（唯一例外：如果之後要加太陽能板邊充邊用，
充電電流就變成硬限制，那時 C3 的 380mA 才有意義。目前不在需求內。）

### C6 的充電 IC：SGM40567-4.2

官方文件只寫「100mA」不給型號，但 Seeed 有公開 KiCad 原理圖，可以直接讀出來：

- **U3 = SGM40567-4.2XG/TR**（SGMICRO，WLCSP-6：VIN / BAT / IREF / nCHG / F / GND）
- **R10 = 200kΩ = IREF 設定電阻**。datasheet 公式 `I_CHG(mA) = 24000 / R_IREF(Ω)`
  → **實際充電電流 120mA，不是官方寫的 100mA**。原理圖上 Seeed 自己也標了
  `ICharge=24000/200K=120mA` 的註記

這顆 IC 提供的保護與**沒有**提供的保護：

| 項目 | 有無 | 說明 |
|---|---|---|
| 涓流預充 | ✅ | Vbat < 60% VCH 時只用 7.5% ICHG = 9mA |
| 過充 / 充飽終止 | ✅ | 6.5% ICHG 終止，跌到 97.8% VCH 自動 recharge |
| IC 過熱回退 | ✅ | die > 130°C 主動降充電電流（保護 IC，不是保護電芯）|
| 拔 USB 後反向漏電 | ✅ | **BAT 漏電僅 0.08µA**，不影響深睡預算 |
| 輸入電壓大幅波動容忍 | ✅ | voltage fold-back holding，**原生支援太陽能充電** |
| **NTC / 電池溫度監控** | ❌ | **最大缺口**。0°C 以下充鋰電會鋰析出 |
| 過放 / 過流 / 短路保護 | ❌ | 那是保護板的工作，見 [`hardware.md`](./hardware.md) |
| 快充安全計時器 | ❌ | 只有 floating charge timeout |

**結論：本專案用板載充電即可，不需外掛充電 IC。**
沒有 NTC 在這裡不構成問題 —— 節點是拿進室內手動充的，一年一次。
反過來說，若日後要加太陽能，SGM40567 原生就是為此設計的，比外掛 TP4056 更合適。
只有「戶外原地充電且冬季低於 0°C」才需要換成帶 NTC 腳的充電 IC。

需注意的是 **S3 的 3.8mA 涓流電流**：鋰電池若深度放電到 3.0V 以下，
充電 IC 會先進入涓流階段，3.8mA 對 3000mAh 電芯等於幾乎不會脫離涓流。
不過本專案韌體在 3.3V 就強制永久休眠，電芯不會落到那個區間，實務上碰不到。

## 各間隔下的實際續航差異

以 18650（可用 2400mAh，含 1.5%/月自放電）、**優化後喚醒視窗 1.0 秒**計算。
數字由 [`../scripts/power_budget.py`](../scripts/power_budget.py) 產生：

| 上傳間隔 | C3 | S3 | **C6** | C6 領先 C3 |
|---|---|---|---|---|
| 5 分鐘 | 9.1 個月 | 9.2 個月 | **9.9 個月** | +9% |
| 15 分鐘 | 16.9 個月 | 19.3 個月 | **20.1 個月** | +19% |
| 30 分鐘 | 21.6 個月 | 26.6 個月 | **27.1 個月** | +26% |

四個值得注意的地方：

1. **間隔越短，板子選型越不重要。** 5 分鐘時上傳佔總耗電 76.2%，
   深睡只佔 4.3%，所以 C6 對 C3 的 3 倍深睡優勢只換到 9% 續航。
   到了 30 分鐘，深睡佔比升高，差距才拉開到 26%
2. **這代表 5 分鐘模式的勝負不在選型，而在 WiFi 優化**。
   同一顆 C6，優化與否是 2.7 個月 vs 9.9 個月（3.7 倍）——
   遠大於任何換板子能帶來的差異。見 [`wifi-optimization.md`](./wifi-optimization.md)
3. **S3 的睡眠優勢被它的 active 劣勢吃掉。** S3 深睡最低（11.9µA），
   但 8MB PSRAM 初始化 + 雙核 Xtensa + 8MB flash 載入 app 讓每次喚醒更慢更耗電
   （模型中估為多 100 ms、多 10 mA）。結果在 5 分鐘時只贏 C3 0.2 個月，
   還輸給 C6。**對「頻繁短喚醒」的應用，PSRAM 是純負擔**
4. C6 在三種間隔都是第一，且沒有任何一項落後 —— 選它不需要權衡

## 選 C6 的理由

1. **深睡 14.3µA，實質接近 S3 最佳值**，遠優於 C3 的 45µA
2. **沒有 PSRAM、單核 RISC-V、4MB flash** —— 喚醒快、active 電流低，避開 S3 的弱點
3. **120mA 充電對本專案夠用**（一年一次充 28 小時）
4. **保留 Zigbee / Thread 退路**：C6 原生支援 802.15.4。如果將來發現 WiFi 上傳
   還是太耗電，可以改走 Thread（單次傳輸能量比 WiFi 低一個數量級），不用重新選板子。
   這個選項價值是 C3/S3 沒有的
5. 官方標稱 15µA 與第三方實測 14.3µA 吻合，數據可信度高

## C6 的風險與代價

- **LMBR4010 二極體的 8µA 反向漏電佔了 C6 深睡的 56%**。理論上可改善，
  但要動板子（拆焊 0402 元件），不建議 —— 除非 M0 實測後發現續航吃緊
- **生態成熟度不如 C3**。C6 較新，Arduino ESP32 core 與部分函式庫的支援時間較短，
  遇到冷門問題可查的資料較少
- **WiFi6 連線時間未知**。C6 接到一般 WiFi 4/5 AP 時走的仍是相容模式，
  理論上與 C3 相當，但 **802.11ax 的能力協商是否會拉長連線時間需要 M0 實測驗證**
- 溫濕度用不到 WiFi6 的任何特性；TWT（Target Wake Time）對「深度睡眠 + 完全斷線」
  的架構沒有幫助，不要被行銷詞誤導

## 什麼情況下改回 C3

- 確定要走 5 分鐘間隔 —— 此時深睡只佔總耗電 4.3%，C6 只領先 9%，
  C3 更成熟的生態與函式庫支援可能更划算
- 之後要加太陽能充電 —— 380mA 充電電流變成硬需求
- C6 在 M0 實測中出現 WiFi 連線時間明顯較長的問題

## 待驗證（M0 必做）

- [ ] 實測 C6 從 BAT 焊盤供電的深睡電流，確認是否接近 14.3µA
- [ ] 實測 C6 從喚醒到 MQTT publish 完成的實際時間與平均電流
- [ ] 對照組：同條件量一片 C3，驗證 3 倍差距是否成立
- [x] ~~確認 C6 的板載充電 IC 型號與實際充電電流~~ —— 已由官方原理圖確認：
      **SGM40567-4.2**，R_IREF = 200kΩ → **120mA**
