HoDZadkiel/EnviroSense/docs/power-budget.md

# 功耗預算與電池壽命

**所有數字由 [`../scripts/power_budget.py`](../scripts/power_budget.py) 產生。
不要手改本文件的數字 —— 改腳本參數然後重跑。**

```bash
python scripts/power_budget.py
```

架構：**每次醒來就量測並立即上傳**，不做批次緩衝。間隔為 5 / 15 / 30 分鐘（另有 1 分鐘，僅供續航測試）。

> **現行設計用 21700（5000 mAh）電池。** 表中的 18650（3000 mAh）是早期設計，留作對照；
> 兩種電池的數字都由腳本同時產生，看 21700 那一列即可。

## 假設值一覽

| 參數 | 值 | 來源 / 理由 |
|---|---|---|
| MCU | XIAO ESP32C6 | 見 [`mcu-selection.md`](./mcu-selection.md) |
| 深睡電流 | **14.3 µA** | Seeed 論壇 PPK2 從 BAT 焊盤實測（唯一有第三方依據的數字） |
| 保護 IC 靜態電流 | **3.0 µA** | 載板 DW01A datasheet typ（max 6.0 µA @3.6V），常時耗電 |
| 喚醒視窗 | 未優化 4.0 s / 優化後 1.0 s | 分階段模型，見 [`wifi-optimization.md`](./wifi-optimization.md) |
| 電池可用比例 | 標稱的 **80%** | 截止電壓 3.3V（非 3.0V）+ 老化與低溫餘裕 |
| 自放電 | **1.5 %/月** | 良品鋰電芯常溫值 |

> ⚠ **除了深睡電流，其餘全是估計值。** 各階段時間有公開文獻依據，
> 但**平均電流完全是估計**，且 1.0 s 是把多份獨立實測拼起來的，不是同一台機器量出來的。
> M0/M2 實測後必須回填。在那之前本文件只能當可行性判斷，不能當規格承諾。

## 喚醒視窗分階段模型

```
能量(mAh) = Σ 各階段(平均電流 mA × 時間 s) / 3600
```

### 未優化（4000 ms，平均 85.0 mA，單次 94.44 µAh）

| 階段 | 時間 | 電流 | 能量佔比 |
|---|---|---|---|
| 開機 / 載入 app（含 image 驗證） | 250 ms | 30 mA | 2.2% |
| WiFi init + start（每次全 PHY 校正） | 300 ms | 60 mA | 5.3% |
| 全頻掃描找 AP | 800 ms | 100 mA | 23.5% |
| 關聯 + WPA2 四次握手 | 1100 ms | 100 mA | **32.4%** |
| DHCP 取得 IP | 1000 ms | 80 mA | 23.5% |
| DNS 查 broker 位址 | 200 ms | 80 mA | 4.7% |
| MQTT 連線 + publish + 斷線 | 300 ms | 90 mA | 7.9% |
| 收尾進睡 | 50 ms | 30 mA | 0.4% |

### 優化後（1000 ms，平均 75.8 mA，單次 21.06 µAh）

| 階段 | 時間 | 電流 | 能量佔比 |
|---|---|---|---|
| 開機 / 載入 app（skip validate） | 150 ms | 30 mA | 5.9% |
| WiFi init + start（PHY 部分校正） | 210 ms | 60 mA | 16.6% |
| 關聯 + WPA2（已知 BSSID/channel） | 350 ms | 100 mA | **46.2%** |
| MQTT 連線 + publish + 斷線（IP 直連） | 250 ms | 90 mA | 29.7% |
| 收尾進睡 | 40 ms | 30 mA | 1.6% |

**能量降為原本的 22%。** 手段逐項說明見 [`wifi-optimization.md`](./wifi-optimization.md)。

## 續航估算

| 間隔 | 未優化 (4.0 s) | **優化後 (1.0 s)** | ESP-NOW (0.45 s) |
|---|---|---|---|
| **18650 (3000mAh)** | | | |
| 5 分鐘 | 2.7 個月 ❌ | **9.9 個月** ✅ | 20.4 個月 |
| 15 分鐘 | 7.2 個月 ✅ | **20.1 個月** ✅ | 30.9 個月 |
| 30 分鐘 | 12.3 個月 ✅ | **27.1 個月** ✅ | 35.5 個月 |
| **21700 (5000mAh)** | | | |
| 5 分鐘 | 4.4 個月 ❌ | 14.7 個月 ✅ | 27.1 個月 |
| 15 分鐘 | 11.0 個月 ✅ | 26.8 個月 ✅ | 37.2 個月 |
| 30 分鐘 | 17.7 個月 ✅ | 33.8 個月 ✅ | 41.0 個月 |

**核心結論：5 分鐘模式的成敗完全取決於 WiFi 優化。**
未優化 2.7 個月（不到目標一半），優化後 9.9 個月（超標 65%）。
15 / 30 分鐘則不論優化與否都達標，優化只是把餘裕從「剛好」變成「充裕」。

## 達標所需的喚醒視窗上限

反推「續航 6 個月」所需的視窗長度：

| 電池 | 5 分鐘 | 15 分鐘 | 30 分鐘 |
|---|---|---|---|
| 18650 (3000mAh) | **≤ 1.85 s** | ≤ 5.56 s | ≤ 11.13 s |
| 21700 (5000mAh) | ≤ 3.14 s | ≤ 9.41 s | ≤ 18.82 s |

這張表是 M2 的驗收標準。實測視窗超過對應數字就代表該模式不可行，
要嘛降頻率、要嘛換 21700、要嘛走 ESP-NOW。

**15 / 30 分鐘的上限寬鬆到幾乎不可能超標**（5.6 s / 11.1 s），
所以如果最終選 15 或 30 分鐘，WiFi 優化就從「必要條件」降級為「延長續航的加分項」。

## 耗電佔比（優化後、5 分鐘、18650）

| 項目 | mAh/day | 佔比 |
|---|---|---|
| **上傳（288 次）** | **6.06** | **76.2%** |
| 自放電 | 1.48 | 18.6% |
| 深睡 | 0.34 | 4.3% |
| 保護 IC（DW01A） | 0.07 | 0.9% |
| 合計 | 7.96 | |

對照 30 分鐘模式（同樣優化後）：

| 項目 | mAh/day | 佔比 |
|---|---|---|
| 上傳（48 次） | 1.01 | 34.8% |
| **自放電** | **1.48** | **50.9%** |
| 深睡 | 0.34 | 11.8% |
| 保護 IC（DW01A） | 0.07 | 2.5% |
| 合計 | 2.90 | |

兩張表說明了為什麼優化的價值隨間隔拉長而遞減：

- **5 分鐘**：上傳佔 76.2%，優化直接決定專案成敗
- **30 分鐘**：自放電反而是最大宗（50.9%），這時再怎麼優化韌體也只是在啃 34.8% 的那一塊。
  **超過 24 個月的估算沒有實務意義** —— 自放電模型與日曆老化的不確定性遠大於負載，
  實務上就規劃一年充一次電

## 21700 值不值得

| 間隔（優化後） | 18650 | 21700 | 提升 |
|---|---|---|---|
| 5 分鐘 | 9.9 個月 | 14.7 個月 | **+48%** |
| 15 分鐘 | 20.1 個月 | 26.8 個月 | +33% |
| 30 分鐘 | 27.1 個月 | 33.8 個月 | +24% |

21700 容量多 67%，但**自放電也多 67%**（2.46 vs 1.48 mAh/day），
所以在低負載模式下提升幅度遠小於容量比例。**間隔越短，21700 越划算。**

只有 5 分鐘模式值得考慮 21700；15 / 30 分鐘用 18650 就已經超過一年，
換 21700 只是把「用不到的續航」變得更用不到，還要付出更大的體積與成本。

## 為什麼截止電壓是 3.3V 不是 3.0V

XIAO 從 BAT 焊盤供電要經過板載 LDO。WiFi 發射瞬間電流可達 250~350 mA，
電池內阻 + LDO 壓降會讓瞬時電壓塌陷。電池靜態電壓若已低於 ~3.4V，
發射瞬間就可能觸發 brownout 重啟 —— 症狀是節點在低電量時開始隨機重開機、資料出現缺口。

韌體分四段處理：

| 電壓 | 動作 |
|---|---|
| > 3.5 V | 正常運作 |
| 3.4 ~ 3.5 V | 發低電量告警（payload 帶旗標），上傳間隔加倍 |
| 3.3 ~ 3.4 V | 只在原間隔的 4 倍時才上傳，盡量延長可觀測時間 |
| < 3.3 V | 發最後一次告警後**永久深睡**（需按 reset 或插 USB 喚醒），保護電芯 |

3.0~3.3V 這段只佔鋰電池總容量約 3~5%，放棄它換穩定性划算。
可用容量取 80% 已含這部分。

## 現場遙測推估（不需量測硬體）

節點已在跑，每筆 `state` 都帶 `up`（喚醒視窗 ms）、`vbat`、`rssi`、`seq`、`flags`，
存在 InfluxDB（`sensor-data`）。**這些資料能取代模型裡的「視窗長度」，但取代不了「電流」**，
所以下表是「實測視窗 × 模型電流」的估算，不是電流實測。

**本節是 2026-10-28 的一次性分析快照**（資料區間 10-16 ~ 10-27 UTC，查詢 InfluxDB `sensor-data`），
不是腳本產生的，也不會自動更新；本文件開頭「所有數字由 `power_budget.py` 產生」不涵蓋本節。
**驗算用的逐筆資料與彙總 CSV、公式說明見 [`data/`](./data/README.md)。**

### 計算方式與排除條件

- **排除充電中的資料**：節點剛上線的開機那筆（`seq 0` / `boot` 旗標）由 USB 供電並充電，
  `vbat` 讀到 4.07 V，拔掉後立刻回到 3.55 V（8e8f50 / 8f4700）。這筆不納入統計。
- **平均喚醒視窗** = `up` 平均 + 290 ms。`up` 只量到「準備 publish」為止，MQTT 連線／送出／收尾
  沿用模型值 290 ms（250 + 40）。平均（不是中位）才會把 `ip_recache` / `wifi_retry` 的慢路徑算進去。
- **平均電流**沿用模型 75.8 mA、深睡 14.3 µA、保護 IC 3.0 µA、可用 80%、自放電 1.5 %/月。
- **`vbat` 不能逐筆看**：同一節點的讀數會在兩個值間跳（901ce4 約 3.98 / 4.05 V、8e8f50 約 3.54 / 3.58 V，
  差 0.04~0.08 V），是 ADC 量化／雜訊，不是充電也不是放電。電壓趨勢一律用**日中位數**，且去掉首尾不完整日。

### 各節點穩定性

| 節點 | 間隔 | 有效天數 | 到達率 | `up` 中位 / 平均 | `up` > 1 s | `vbat` 日中位 / 日斜率 | RSSI 中位 |
|---|---|---|---|---|---|---|---|
| 8ef074 | 5 分鐘 | 11.1 | 100% | 523 / 549 ms | 0.47% | 4.09 V / 0.0 mV | -37 dBm |
| 901ce4 | 1 分鐘 | 11.1 | 94.3% | 522 / 624 ms | **3.14%** | 4.02 V / -10.1 mV | -53 dBm |
| 8e8f50 | 1 分鐘 | 6.1 | 96.1% | 523 / 530 ms | 0.20% | 3.55 V / -4.0 mV | -61 dBm |
| 8f4700 | 5 分鐘 | 6.1 | 81.7%* | 523 / 553 ms | 0.42% | 3.55 V / 0.0 mV | -38 dBm |

\* 8f4700 的缺口來自 10-22 改名重開機後 seq 歸零，InfluxDB 橋接程式丟棄資料（缺約 1479 分鐘），
是資料庫側問題，不是節點故障。

- **正常路徑的視窗在四台上完全一致**（中位 522~523 ms），且遠低於模型假設的 1.0 s。
  差異全來自慢路徑的占比：901ce4 有 432 次 `ip_recache`（每次 3.6~4.2 s），平均被拉高到 624 ms。
- 缺口與漏號由 `pending` 補送，901ce4 最長中斷 7 分鐘。
- 8ef074 濕度長期 ≈ 19%（其他三台 70~82%），SHT40 疑似故障，與耗電無關但要處理。

### 5000mAh（21700，三星）續航推估（只採新韌體）

**只採新韌體節點**（8e8f50、8f4700；payload 有 `bssid`，0.2.1-ha 以上）。
舊韌體的 901ce4、8ef074 不納入估算：901ce4 的 `ip_recache` 發生率 2.9%（新韌體約 0.1~0.14%），
會把平均視窗拉高 10~15%，那是舊版問題，不代表現行韌體。兩台的資料仍保留在 CSV 供對照。

| 節點 | 有效筆數 | `up` 中位 / 平均 | 平均喚醒（+290 ms） |
|---|---|---|---|
| 8e8f50（1 分鐘） | 8474 | 523 / 530 ms | 820 ms |
| 8f4700（5 分鐘） | 1439 | 523 / 553 ms | 843 ms |
| **合併（9913 筆）** | 9913 | 523 / 534 ms | **824 ms** |

以合併的 824 ms 代入（兩台間隔不同，視窗卻幾乎相同，所以可以共用）：

| 上傳間隔 | 每日耗電 | **5000mAh 續航** |
|---|---|---|
| 1 分鐘 | 25.38 mAh | 4.7 個月 |
| **5 分鐘** | 5.41 mAh | **16.7 個月** |
| 15 分鐘 | 2.08 mAh | 28.9 個月 |
| 30 分鐘 | 1.25 mAh | 35.4 個月 |

與上方模型表（21700、優化後 1.0 s：5 分鐘 14.7 / 15 分鐘 26.8 / 30 分鐘 33.8 個月）相比，
實測視窗 824 ms 比 1.0 s 短，所以多約 2 個月；**若 PPK2 量出的平均電流高於 75.8 mA，這些數字會等比下修。**
注意 8e8f50 / 8f4700 目前電池僅約 3.55 V，下表是滿電推估，這兩台實際剩餘壽命見下方「低電量節點」。

**交叉驗證**（用舊韌體的 901ce4，僅檢查模型量級，不用於上表）：901ce4 以 28.1 mAh/day 運行，日斜率 -10.1 mV 與這個耗電量級吻合
（約每天消耗 3000mAh 電芯的 0.9%；鋰電池在 4.1 V 附近約 15 mV / % SoC）。
8ef074 為 0.0 mV/天：5 分鐘模式每天只用約 5.5 mAh（約 0.2% 的 3000mAh），遠小於 ADC 解析度，
11 天內看不出斜率，**這不代表沒在耗電**。

### 低電量節點

8e8f50 / 8f4700 的電池日中位 3.55 V，離韌體截止電壓 3.30 V 僅剩約 15%（粗估 ≈ 700 mAh，
依電壓—電量曲線估，誤差大）。**上表是滿電推估，這兩台不適用**：

| 節點 | 間隔 | 耗電 | 到 3.30 V 粗估 |
|---|---|---|---|
| 8e8f50 | 1 分鐘 | 25.3 mAh/day | 約 4 週 |
| 8f4700 | 5 分鐘 | 5.5 mAh/day | 約 4 個月 |

兩台都已帶 `low_batt` 旗標（韌體在 < 3.5 V 時已拉長間隔，所以實際到達率低於預期）。
充飽後需要重新取樣。

## 實測驗證

**未實測前，電流相關數字都不可信**（視窗長度已有遙測支撐，見上一節）。
**量測硬體（PPK2 / 示波器）尚未到位，本節各項的執行時程未知**，
在那之前以上一節的遙測推估當暫代，並照下表追蹤。

### 測試項目一覽

| 項目 | 目的 | 需要的硬體 | 狀態 | 暫代方案（無硬體） |
|---|---|---|---|---|
| **M0** 深睡電流 | 驗證 14.3 µA（+DW01A ≈ 17.3 µA） | PPK2 或 µA 檔萬用表 | ⏳ 待硬體，時程未知 | 無；深睡只佔 5 分鐘模式 4.3%，影響有限 |
| **M2-a** 各階段電流 | 取代模型 75.8 mA | PPK2（或 10 Ω + 示波器） | ⏳ 待硬體，時程未知 | 遙測的 `up` 已證明視窗；**電流無暫代** |
| **M2-b** WiFi 優化 A/B | BSSID 快取是否有效 | 不需要 | 可做 | 比對 `cache_miss` 旗標率與 `up` 分佈 |
| **M6** 長期放電曲線 | 外推續航（唯一可寫進規格的數字） | 不需要 | 🔄 進行中（四節點在跑） | 用日中位數 `vbat` 斜率 |
| **T1** `vbat` 量測精度 | 解決 ADC 逐筆跳 0.04~0.08 V | 萬用表（對照）即可 | 待排程 | 取日中位數 |
| **T2** 電壓—電量曲線 | 讓 `vbat` 能換算剩餘容量 | 電子負載或定電流放電（可用 PPK2 替代） | ⏳ 待硬體 | 用文獻 NMC 曲線粗估 |
| **T3** 大電流 brownout 邊界 | 驗證 3.3 V 截止點是否夠 | 示波器 + 電池夾具 | ⏳ 待硬體 | 觀察低電量節點是否出現隨機重開機（`boot` 旗標） |

### 現在就能做（不需量測硬體）

1. **之後想複查時再查一次 InfluxDB**：看 `up > 1 s` 占比、
   `ip_recache` 次數、`wifi_err` 是否變多。判準：占比持續上升或 `up` 中位數離開 523 ms，
   就是視窗在劣化。
2. **M6 斜率核對**：資料累積 ≥ 4 週後，用 `vbat` 日中位數線性回歸；**用 `vbat` 曲線的斜率校正
   模型的 75.8 mA**（`平均電流 ≈ 斜率 ÷ 單位 SoC 電壓 × 電池容量`）。5 分鐘節點需要更長時間才能超過 ADC 解析度，
   1 分鐘節點（901ce4）是最快的校準來源。
3. **M2-b**：`cache_miss` 在 11 天內僅出現 1 次（8f4700），尚未見到 BSSID 快取失效；
   若要判斷快取有沒有加速，需要對照關閉快取的節點，才有 A/B。
4. **T1**：任選一台用萬用表量電池端電壓，與同一時間的 `vbat` 對照，確認 ADC 偏差與跳動範圍。
5. **低電量節點**：8e8f50 / 8f4700 充飽後重取樣，並記下充飽時間點，之後的資料才能用來外推。

### 硬體到位後的優先順序

1. **M2-a**：只要拿到各階段電流，就能把「估算」變成「實測」，這是對續航影響最大的未知數。
2. **M0**：確認載板焊接沒有漏電（DW01A、C2、分壓閘控）。
3. **T3**：確認 3.3 V 截止點在實際大電流下是否足以避免 brownout。
4. **T2**：建立電壓—電量曲線，讓 `vbat` 可直接換算剩餘容量。

### M0：深度睡眠電流

- **建議工具**：Nordic Power Profiler Kit II（PPK2），可直接讀 µA 並看波形
- **替代方案**：好一點的萬用表 µA 檔，串在電池正極與 BAT 焊盤之間
- **接法**：從 BAT 焊盤供 3.8V（模擬半滿電池），**不要接 USB**
- **注意**：插著 USB 時板載充電 IC 會同時供電與充電，量到的數字毫無意義
- **一定要用 release build**（Serial / USB CDC 全關）

驗收：接近 14.3 µA。若超過 30 µA，先查是不是分壓沒閘控、或有 GPIO 浮接。

在實體載板上從電芯端量時，還會多出 DW01A 的 3~6 µA，驗收值改為 **~17.3 µA**
（C2 470µF 未焊時；焊上後的差值即 C2 漏電，見 [`hardware.md`](./hardware.md)）。

### M2：喚醒視窗的時間與各階段電流

- 電池負極串 **10 Ω / 1%** 電阻，示波器量兩端壓降（1 mV = 0.1 mA）
- 要拿到的是[分階段模型](#喚醒視窗分階段模型)那張表的**每一列**，不是只有總時間
- 重點確認：WiFi 關聯到底花多久？若超過 1 秒，代表 BSSID 快取或靜態 IP 沒有生效
- 同時做 [`wifi-optimization.md`](./wifi-optimization.md) 的 A/B 對照清單

### 回填

把實測值改進 `scripts/power_budget.py` 的 `SCENARIOS`，重跑，
更新本文件、README 與 docs/overview.md 的表格，並在 `DEVLOG.md` 記錄實測條件（溫度、電池電壓、RSSI、AP 型號）。

### M6：長期驗證

短期量測外推會漏掉自放電與日曆老化。至少跑一顆節點 30 天，
記錄電池電壓曲線，用實際斜率反推續航 —— 這才是能寫進規格的數字。
同時把每筆 payload 的 `up` 欄位存進資料庫，觀察喚醒視窗是否隨時間劣化。
