HoDZadkiel/EnviroSense/hardware/bom/BOM_Board1_PCB1_2026-08-21.xlsx

No. | Quantity | Comment | Designator | Footprint | Value | Manufacturer Part | Manufacturer | Supplier Part | Supplier
1 | 3 | 100nF | C1,C3,C4 | C0603 | 100nF | CC0603KRX7R9BB104 | YAGEO(国巨) | C14663 | LCSC
2 | 1 | 470uF | C2 | CAP-SMD_L7.3-W4.3 | 470uF | 6TPE470MI | PANASONIC(松下) | C402828 | LCSC
3 | 1 | 2N7002 | Q2 | SOT-23-3_L2.9-W1.3-P1.90-LS2.4-BR |  | 2N7002 | CJ(江苏长电/长晶) | C8545 | LCSC
4 | 1 | 8205A | Q3 | SOT-23-6_L2.9-W1.6-P0.95-LS2.8-BR |  | 8205A | JSMSEMI(杰盛微) | C2762931 | LCSC
5 | 2 | 2MΩ | R1,R2 | R0603 | 2MΩ | RC0603FR-072ML | YAGEO(国巨) | C114615 | LCSC
6 | 2 | 10kΩ | R3,R4 | R0603 | 10kΩ | 0603WAF1002T5E | UNI-ROYAL(厚声) | C25804 | LCSC
7 | 1 | 100Ω | R5 | R0805 | 100Ω | 0805W8F1000T5E | UNI-ROYAL(厚声) | C17408 | LCSC
8 | 1 | 1kΩ | R6 | R0805 | 1kΩ | 0805W8F1001T5E | UNI-ROYAL(厚声) | C17513 | LCSC
9 | 4 | Screw-Hole-M3 | SCREW1,SCREW2,SCREW3,SCREW4 | Screw-Hole-M3
10 | 1 | DW01A | U1 | SOT-23-6_L2.9-W1.6-P0.95-LS2.8-BL |  | DW01A | PUOLOP(迪浦) | C351410 | LCSC
11 | 1 | SHT40-N-NF | U2 | DFN-4_L1.5-W1.5-P0.80-TL-EP |  | SHT40-N-NF | Nyfea(徕飞) | C54946589 | LCSC
12 | 1 | XIAO-ESP32-C6 | U3 | LCC-14P_L17.7-W20.8-XIAO-ESP32-C6 |  | XIAO-ESP32-C6 |  | C9900124963 | LCSC
13 | 1 | BH-21700-B1BJ001 | U4 | BAT-SMD_L82.5.5-W25-BH-21700-B1BJ001 |  | BH-21700-B1BJ001 | MYOUNG(美阳) | C20606791 | LCSC
