HoDZadkiel/EnviroSense/(commit log)

2026-10-27 EnviroSense: 公開版初始提交（文件、硬體、預編譯韌體 0.2.2-ha、網頁燒錄）
    韌體原始碼不公開，只發佈 firmware/release 的二進位檔與燒錄工具。
    [BOM_Board1_PCB1_2026-08-21.xlsx, BOM_Board1_PCB1_2026-08-21_LCSC-upload.xlsx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]
2026-10-27 發佈流程改為 Release + Pages 自動部署，網頁燒錄頁模板化
    - 新增 pages.yml：Release 發佈時下載 merged.bin、驗證 SHA256SUMS 後部署 GitHub Pages
    - 新增 no-source-guard.yml：偵測到原始碼 / config.h / DEVLOG / .env 被追蹤就失敗
    - web-flasher：manifest 與 index 改模板（__VERSION__ / __BIN__），merged.bin 不再入版控
    - README 補 Releases 連結；Linux/macOS 燒錄指令改 bash flash.sh
2026-10-27 pages.yml 改為只能手動觸發
    release 事件觸發的 pages 以 tag 為 ref，會被 github-pages 環境的
    「只允許 main」規則擋下，每次發佈都留下一次失敗的執行。
    改成 workflow_dispatch，發佈後從 main 手動執行，部署最新一版 Release。
2026-10-27 網頁燒錄頁：加入專案連結，並註明需要 EnviroSense 載板
    - 頁面頂部加警示：韌體為 EnviroSense 載板設計，單獨的 XIAO ESP32C6 無法正常量測，附 hardware 資料夾連結
    - 「關於」加入 GitHub 專案連結；清除與設定說明補上載板需求
2026-10-27 README 改 GitHub 風格並依現行設計更新文件
    - README 重寫：特色、Mermaid 運作圖、規格與續航、快速開始、硬體腳位、文件索引、Roadmap
    - 舊 README 的完整設計說明移到 docs/overview.md，並更新過時內容：
    電池改以 21700（5000 mAh）為準、設定頁改連按兩次 RESET、里程碑與未完成項目對照現場運行、
    移除「尚未初始化 git」、結構樹改為現況
    - 新增 CLAUDE.md（給 agent 的專案說明，不含內網資訊）
    - power-budget / wifi-optimization / mcu-selection / provisioning 補註 18650 與 BOOT 鍵為早期設計
    - hardware/README、deploy/README、firmware/README、CHANGELOG 修正過時敘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
2026-10-28 更換 0.2.2-ha 預編譯韌體：修正設定頁無法連線
    原發佈版本燒錄後無法連上設定頁（portal），以 config.h.example 等效設定
    重新編譯後正常。app / merged 與 SHA256SUMS 已更新；bootloader、分區表、
    boot_app0 不變。編譯時 USB CDC On Boot 為 Enabled（與 firmware/README
    建議的 Disabled 不同），根因與功耗影響待驗證。
2026-10-28 文件：記錄網頁燒錄實機驗證結果
    網頁燒錄 0.2.2-ha（重新發佈版）實機驗證成功，可連上設定頁。
    README 待辦拆成網頁燒錄（已驗證）與 flash.bat（未驗證）；
    web-flasher/README 更新驗證狀態並註明 CDC On Boot 與建議值不同。
2026-10-29 網頁燒錄頁：換用新版介面（保留 __VERSION__ 與 manifest 串接）
