HoDZadkiel/EnviroSense/(notices)

Notices in the files:
README.md:
License: not specified
